santhazsolt/stm32-based-quadcopter-drone/hardware/image/3D/3D.pdf

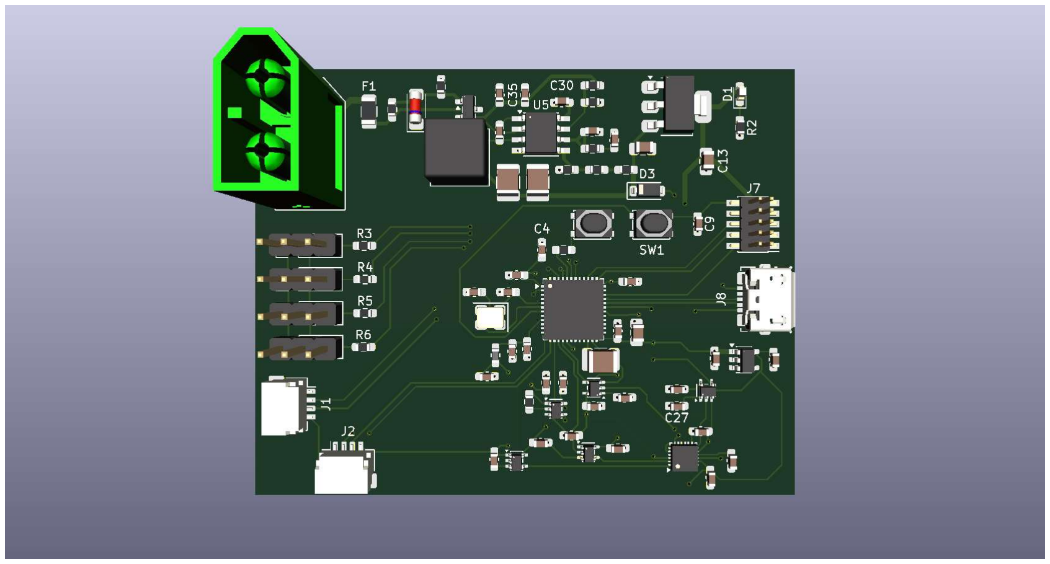
[picture p24: figure]
