santhazsolt/stm32-based-quadcopter-drone/hardware/image/pcb/flight_controllerV1_PCB.png

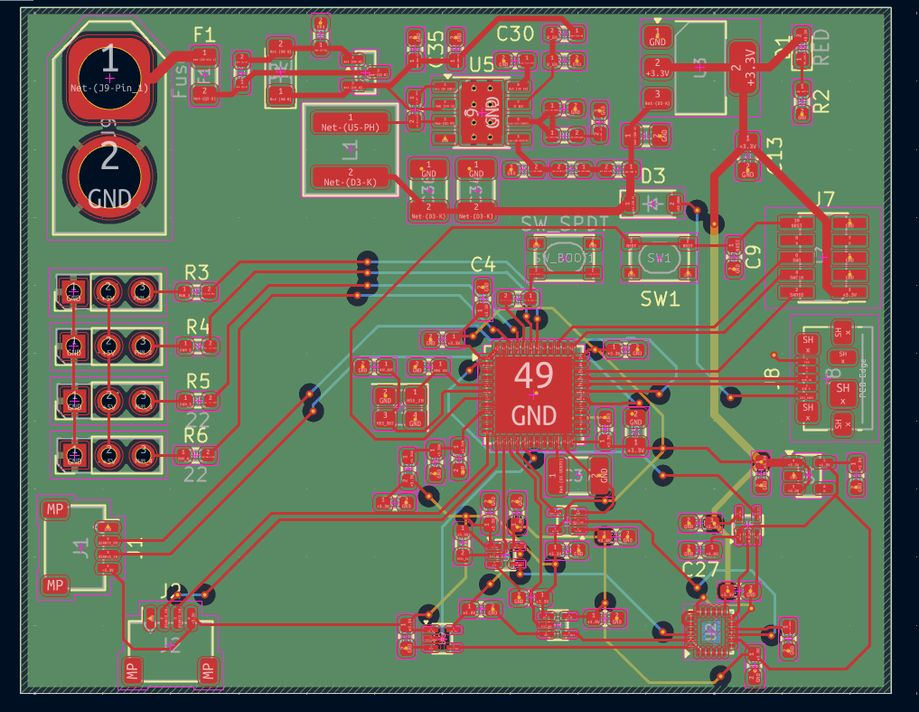
hardware/image/pcb/flight_controllerV1_PCB.png
