santhazsolt/stm32-based-quadcopter-drone/image/schematic/flight_controller_version1.pdf

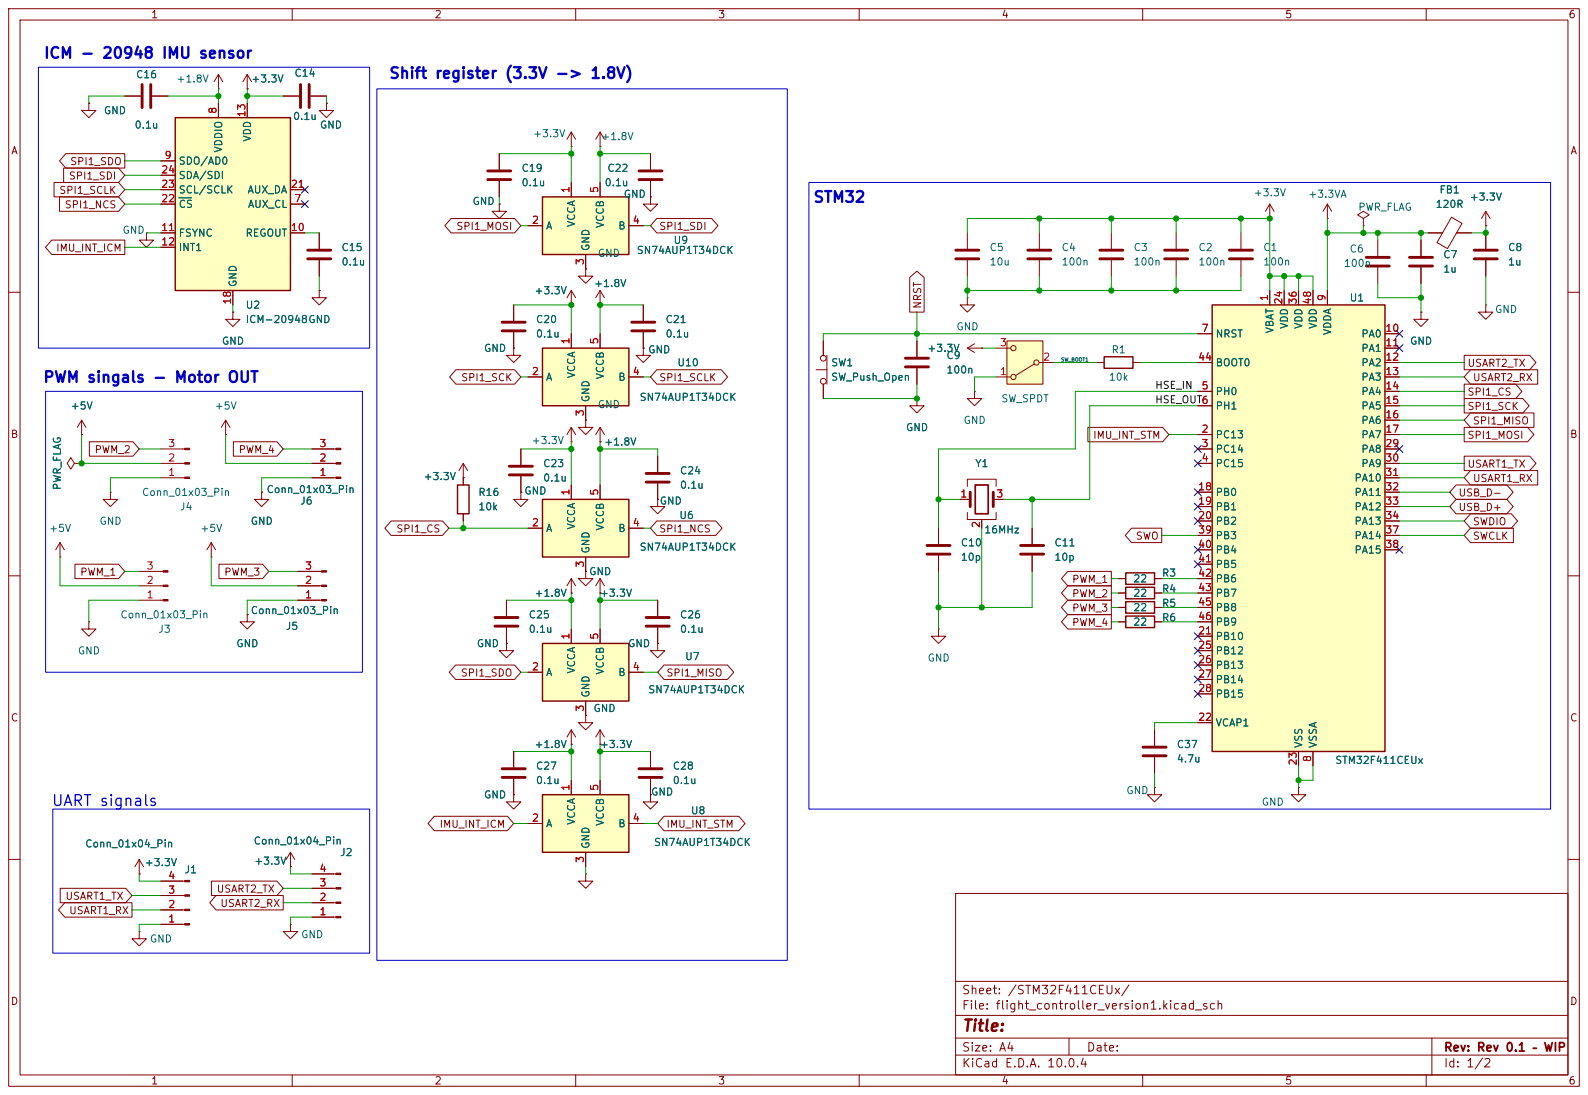
[picture p26: page 1]

Size: A4 | Rev: Rev 0.1 – WIP
KiCad E.D.A. 10.0.4 | Id: 1/2

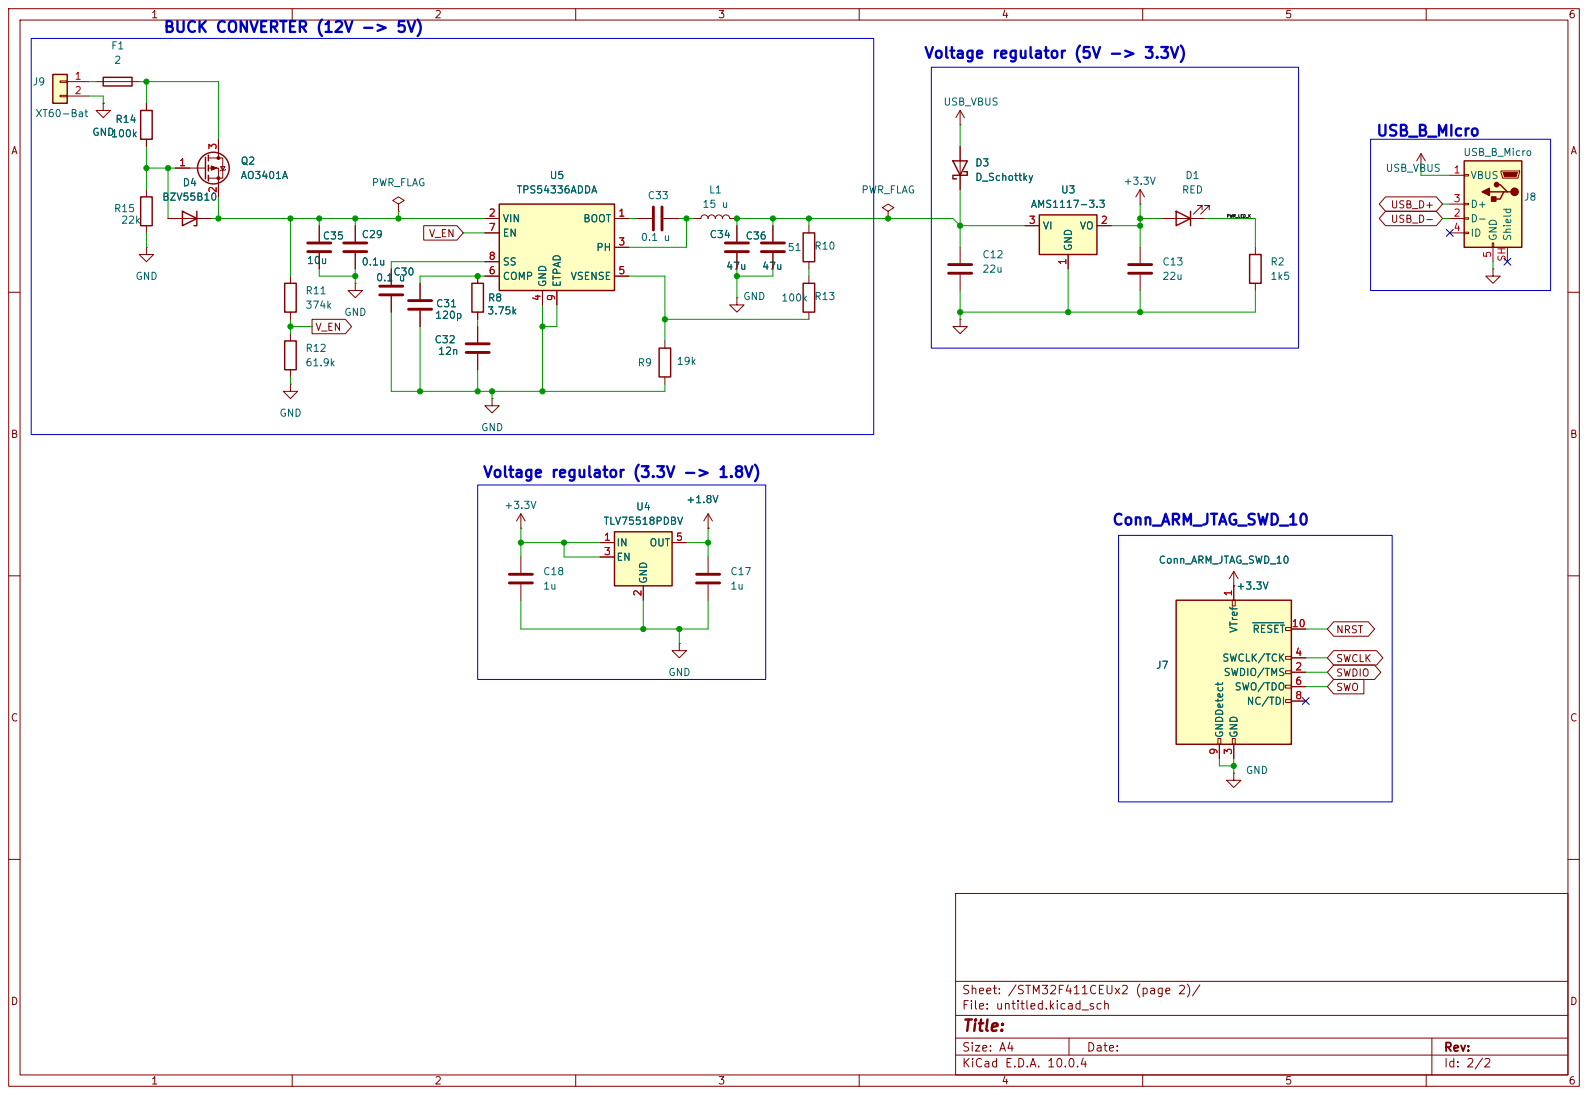
[picture p27: page 2]

Size: A4 | Rev:
KiCad E.D.A. 10.0.4 | Id: 2/2
