santhazsolt/stm32-based-quadcopter-drone/hardware/image/pcb/flight_controller_version1-B_Cu.pdf

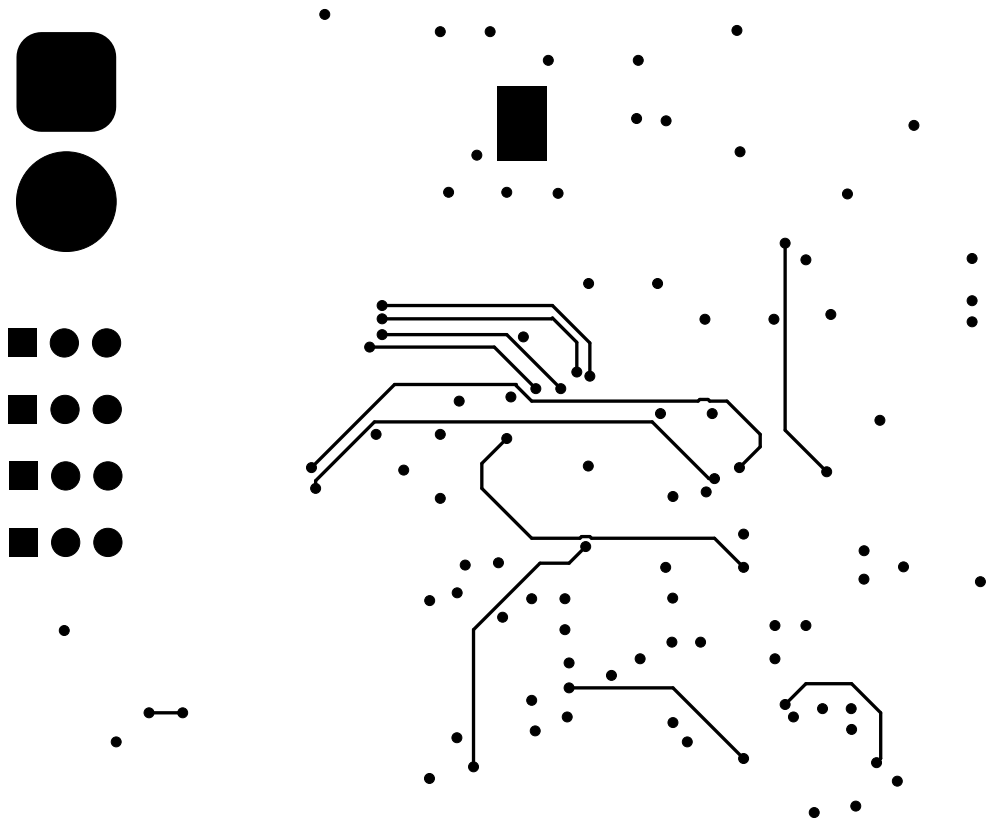
[picture p28: page 1]
