santhazsolt/stm32-based-quadcopter-drone/hardware/image/pcb/flight_controller_version1-B_Mask.pdf

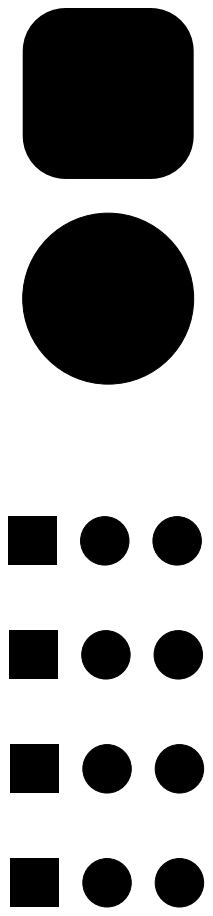
[picture p29: page 1]
