santhazsolt/stm32-based-quadcopter-drone/hardware/image/pcb/flight_controller_version1-F_Silkscreen.pdf

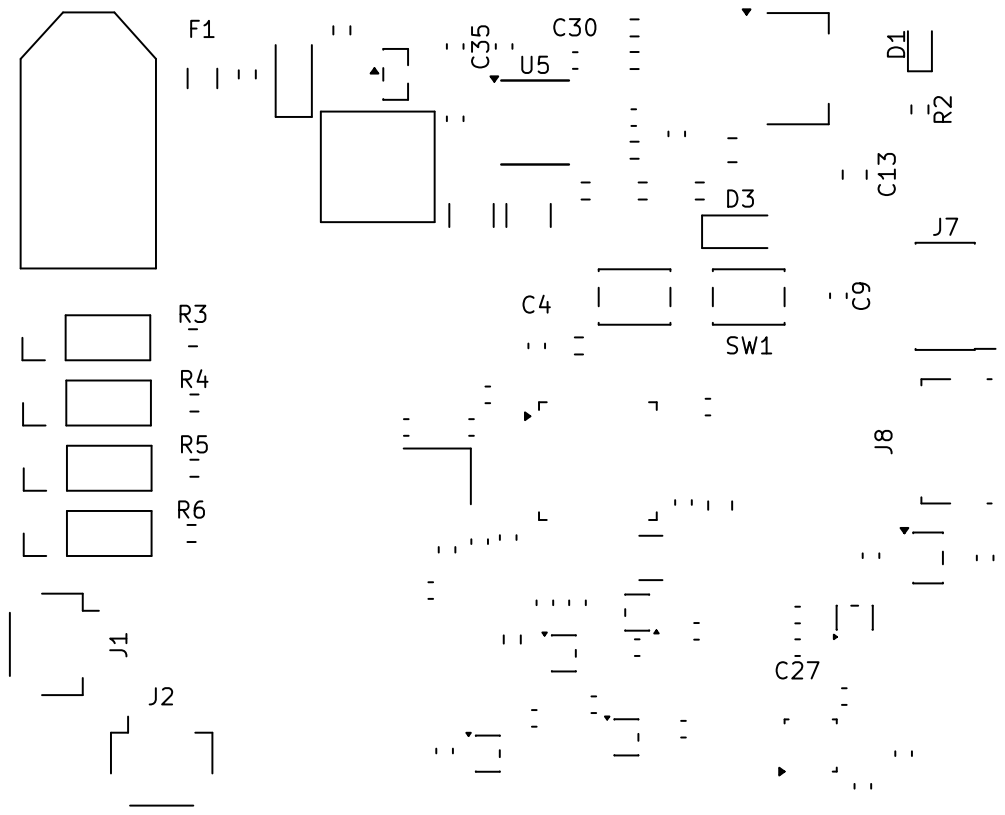
[picture p30: page 1]
