santhazsolt/stm32-based-quadcopter-drone/hardware/image/pcb/flight_controller_version1-In1_Cu.pdf

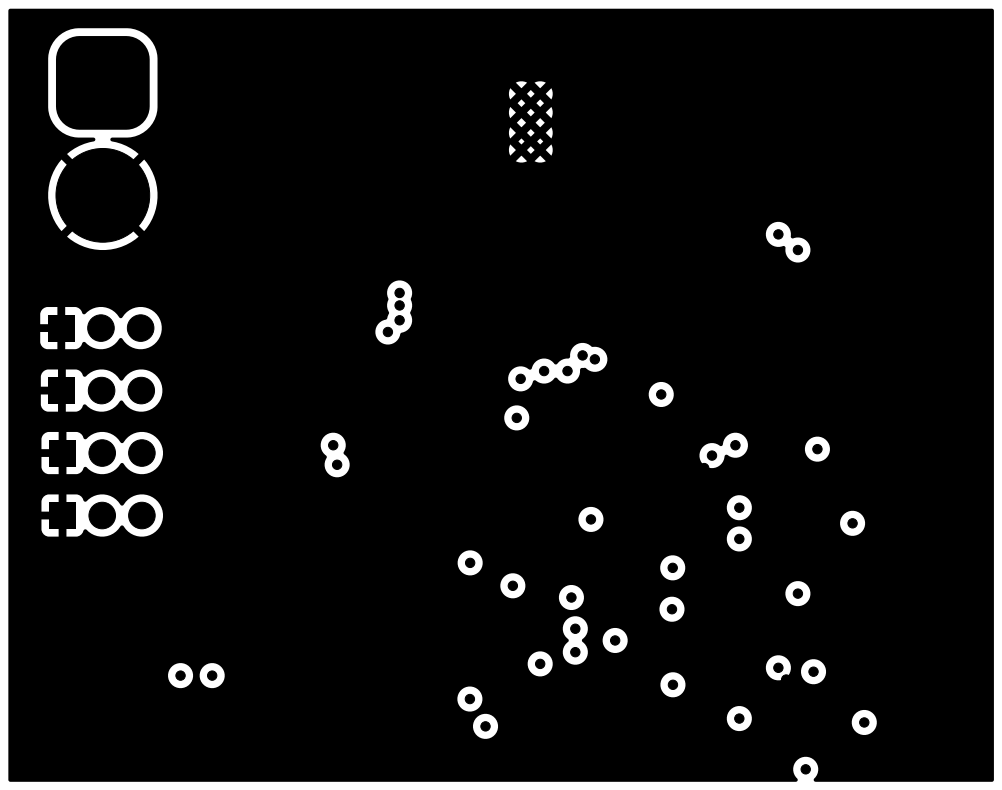
[picture p31: page 1]
