santhazsolt/stm32-based-quadcopter-drone/hardware/image/pcb/flight_controller_version1-In2_Cu.pdf

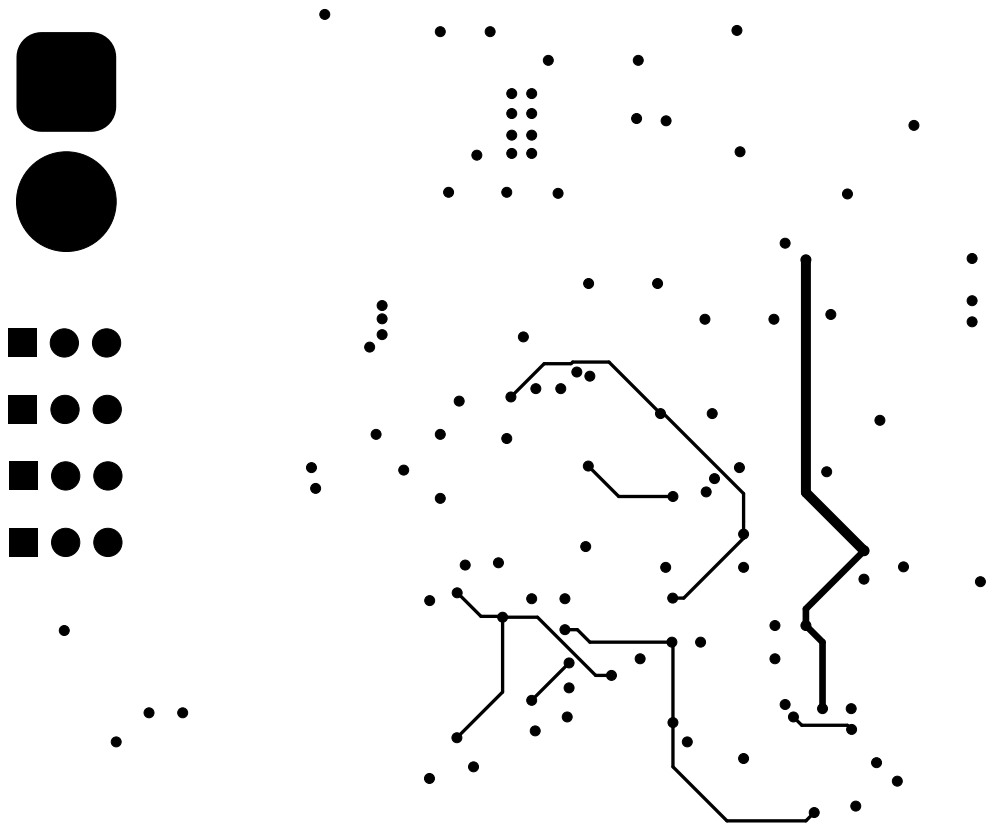
[picture p32: page 1]
