santhazsolt/stm32-based-quadcopter-drone/image/pcb/flight_controller_version1-F_Cu.pdf

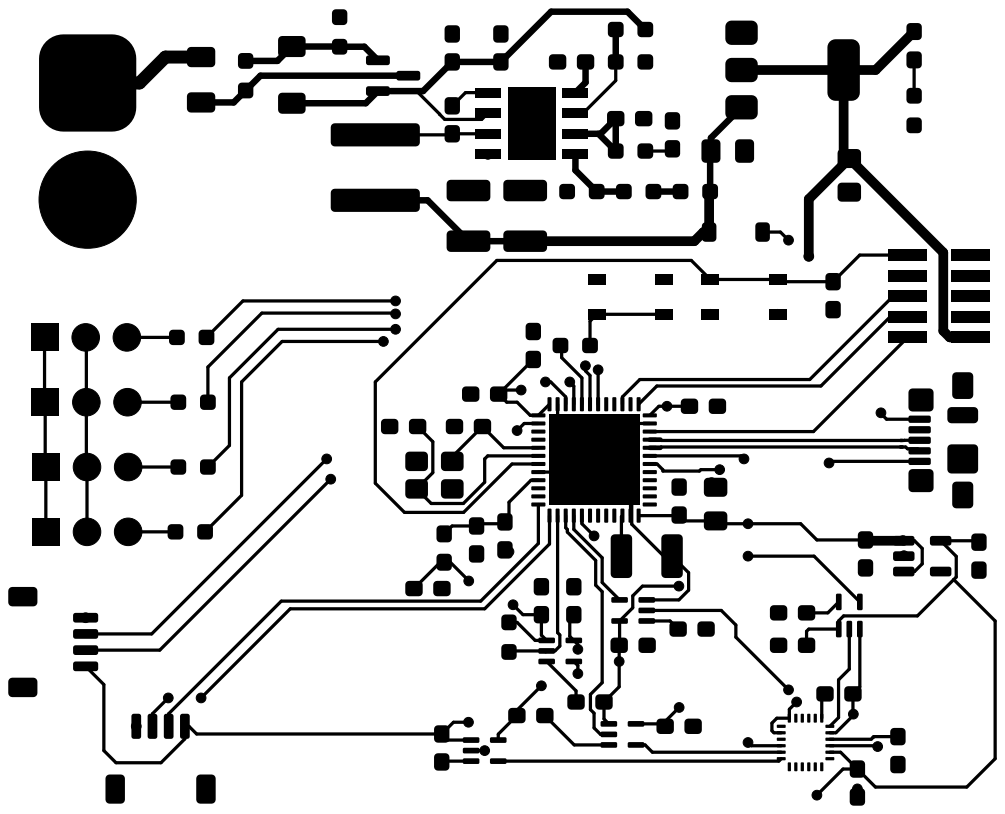
[picture p33: page 1]
