santhazsolt/stm32-based-quadcopter-drone/image/pcb/flight_controller_version1-F_Mask.pdf

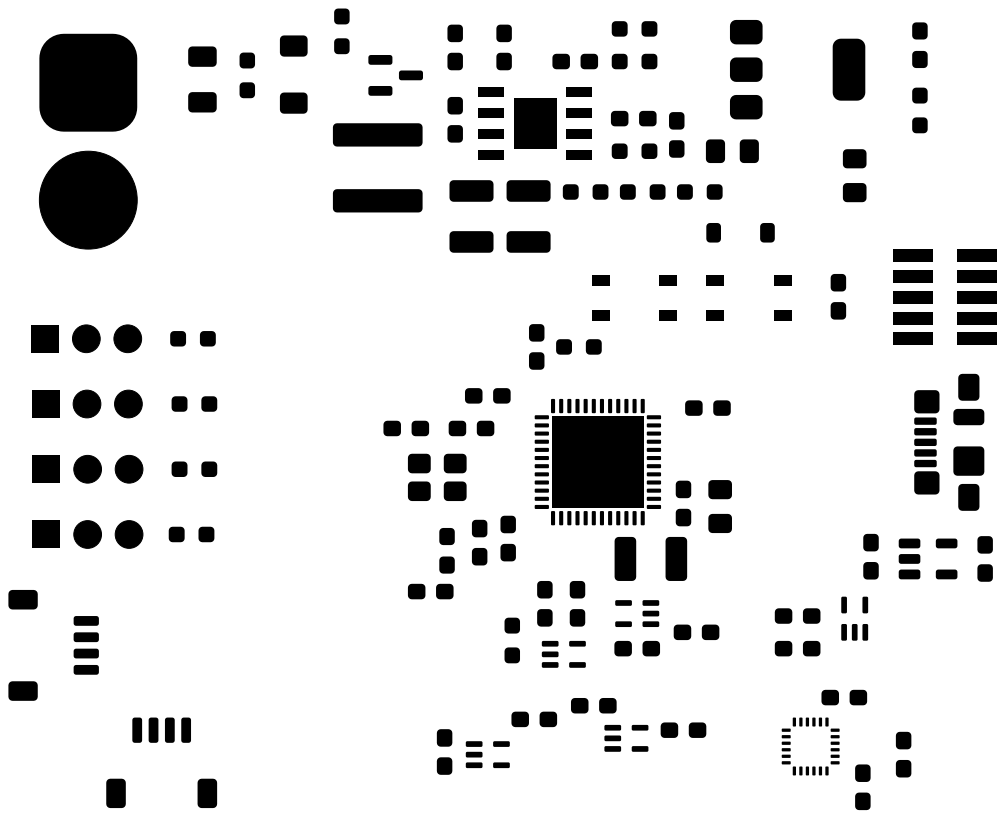
[picture p34: page 1]
