santhazsolt/stm32-based-quadcopter-drone/image/pcb/flight_controller_version1-F_Paste.pdf

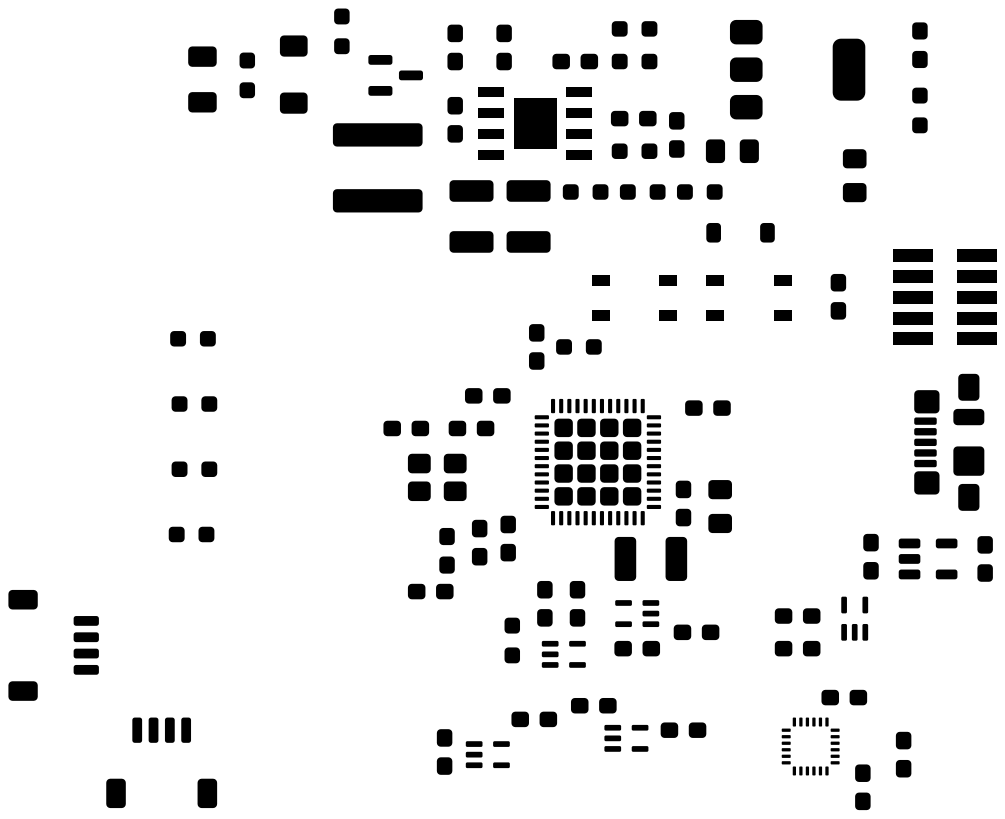
[picture p35: page 1]
