santhazsolt/stm32-based-quadcopter-drone/hardware/pcb/flight_controller_version1.kicad_pcb

## KiCad design hardware/pcb/flight_controller_version1.kicad_pcb (2026-10-06)

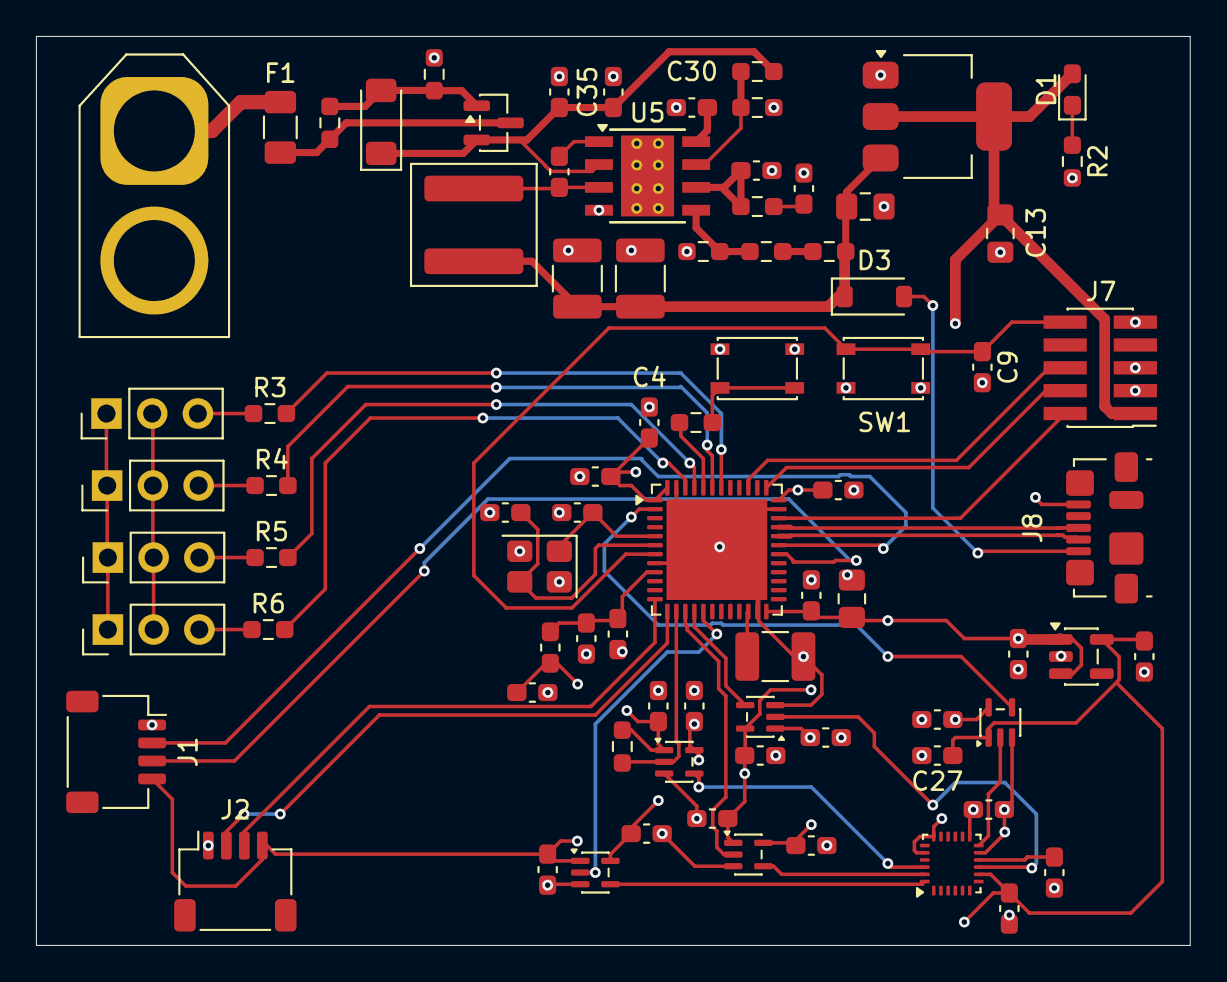
[picture p36: board flight_controller_version1.kicad_pcb from above]

Board: 4 copper layers, 64.1 x 50.5 mm, 81 parts (0 on the bottom side), 54 nets.

Parts:
C1, C2, C3, C4, C6, C9: 100n; C_0603_1608Metric_Pad1.08x0.95mm_HandSolder
C5: 10u; C_0805_2012Metric_Pad1.18x1.45mm_HandSolder
C7, C8, C17, C18: 1u; C_0603_1608Metric_Pad1.08x0.95mm_HandSolder
C10, C11: 10p; C_0603_1608Metric_Pad1.08x0.95mm_HandSolder
C12, C13: 22u; C_0805_2012Metric_Pad1.18x1.45mm_HandSolder
C14, C15, C16, C19, C20, C21, C22, C23, C24, C25, C26, C27, C28, C29: 0.1u; C_0603_1608Metric_Pad1.08x0.95mm_HandSolder
C30, C33: 0.1 u; C_0603_1608Metric_Pad1.08x0.95mm_HandSolder
C31: 120p; C_0603_1608Metric_Pad1.08x0.95mm_HandSolder
C32: 12n; C_0603_1608Metric_Pad1.08x0.95mm_HandSolder
C34, C36: 47u; C_1210_3225Metric_Pad1.33x2.70mm_HandSolder
C35: 10u; C_0603_1608Metric_Pad1.08x0.95mm_HandSolder
C37: 4.7u; C_1210_3225Metric_Pad1.33x2.70mm_HandSolder
D1: RED; LED_0603_1608Metric_Pad1.05x0.95mm_HandSolder
D3: D_Schottky; D_SOD-123
D4: BZV55B10; D_MiniMELF
F1: Fuse; Fuse_1206_3216Metric
FB1: 120R; L_0603_1608Metric_Pad1.05x0.95mm_HandSolder
J1, J2: Conn_01x04_Pin; JST_SH_SM04B-SRSS-TB_1x04-1MP_P1.00mm_Horizontal
J3, J4, J5, J6: Conn_01x03_Pin; PinHeader_1x03_P2.54mm_Vertical
J7: Conn_ARM_JTAG_SWD_10; PinHeader_2x05_P1.27mm_Vertical_SMD
J8: USB_B_Micro; USB_Micro-B_Molex_47346-0001
J9: XT60-Bat; AMASS_XT60-M_1x02_P7.20mm_Vertical
L1: 15 u; L_Coilcraft_XAL6060-XXX
Q2: AO3401A; SOT-23
R1, R16: 10k; R_0603_1608Metric_Pad0.98x0.95mm_HandSolder
R2: 1k5; R_0603_1608Metric_Pad0.98x0.95mm_HandSolder
R3, R4, R5, R6: 22; R_0603_1608Metric_Pad0.98x0.95mm_HandSolder
R8: 3.75k; R_0603_1608Metric_Pad0.98x0.95mm_HandSolder
R9: 19k; R_0603_1608Metric_Pad0.98x0.95mm_HandSolder
R10: 51; R_0603_1608Metric_Pad0.98x0.95mm_HandSolder
R11: 374k; R_0603_1608Metric_Pad0.98x0.95mm_HandSolder
R12: 61.9k; R_0603_1608Metric_Pad0.98x0.95mm_HandSolder
R13, R14: 100k; R_0603_1608Metric_Pad0.98x0.95mm_HandSolder
R15: 22k; R_0603_1608Metric_Pad0.98x0.95mm_HandSolder
SW1: SW_Push_Open; SW_SPST_PTS810
SW_BOOT1: SW_SPDT; SW_SPST_PTS810
U1: STM32F411CEUx; QFN-48-1EP_7x7mm_P0.5mm_EP5.6x5.6mm
U2: ICM-20948; InvenSense_QFN-24_3x3mm_P0.4mm
U3: AMS1117-3.3; SOT-223-3_TabPin2
U4: TLV75518PDBV; SOT-23-5
U5: TPS54336ADDA; TI_SO-PowerPAD-8_ThermalVias
U6, U7, U8, U9, U10: SN74AUP1T34DCK; SOT-353_SC-70-5
Y1: 16MHz; Crystal_SMD_3225-4Pin_3.2x2.5mm

Connections:
+1.8V: C16.1, C17.1, C21.1, C22.1, C24.1, C25.1, C27.1, U2.8 (VDDIO), U4.5 (OUT), U6.5 (VCCB), U7.1 (VCCA), U8.1 (VCCA), U9.5 (VCCB), U10.5 (VCCB)
+3.3V: C1.1, C2.1, C3.1, C4.1, C5.1, C8.1, C13.1, C14.1, C18.1, C19.1, C20.1, C23.1, C26.1, C28.1, D1.2 (A), FB1.2, J1.4, J2.4, J7.1 (VTref), R16.1, U1.1 (VBAT), U1.24 (VDD), U1.36 (VDD), U1.48 (VDD), U2.13 (VDD), U3.2 (VO), U4.1 (IN), U4.3 (EN), U6.1 (VCCA), U7.5 (VCCB), U8.5 (VCCB), U9.1 (VCCA), U10.1 (VCCA)
+3.3VA: C6.1, C7.1, FB1.1, U1.9 (VDDA)
+5V: J3.2, J4.2, J5.2, J6.2
/STM32F411CEUx2 (page 2)/PWR_LED_K: D1.1 (K), R2.1
/STM32F411CEUx/HSE_IN: C10.1, U1.5 (PH0), Y1.1
/STM32F411CEUx/HSE_OUT: C11.1, U1.6 (PH1), Y1.3
GND: C1.2, C2.2, C3.2, C4.2, C5.2, C6.2, C7.2, C8.2, C9.2, C10.2, C11.2, C12.2, C13.2, C14.2, C15.2, C16.2, C17.2, C18.2, C19.2, C20.2, C21.2, C22.2, C23.2, C24.2, C25.2, C26.2, C27.2, C28.2, C29.2, C30.2, C31.2, C32.1, C34.1, C35.2, C36.1, C37.2, J1.1, J2.1, J3.1, J4.1, J5.1, J6.1, J7.3 (GND), J7.5 (GND), J7.9 (GNDDetect), J8.5 (GND), J9.2, R2.2, R9.1, R12.2, R15.2, SW1.1 (A), SW_BOOT1.1 (A), U1.8 (VSSA), U1.23 (VSS), U1.35 (VSS), U1.47 (VSS), U1.49 (VSS), U2.11 (FSYNC), U2.18 (GND), U2.20 (GND), U3.1 (GND), U4.2 (GND), U5.4 (GND), U5.9 (ETPAD), U6.3 (GND), U7.3 (GND), U8.3 (GND), U9.3 (GND), U10.3 (GND), Y1.2 (G), Y1.4 (G)
IMU_INT_ICM: U2.12 (INT1), U8.2 (A)
IMU_INT_STM: U1.2 (PC13), U8.4 (B)
NRST: C9.1, J7.10 (~RESET), SW1.2 (B), U1.7 (NRST)
unnamed: C32.2, R8.2
unnamed: C12.1, C34.2, C36.2, D3.1 (K), L1.2, R10.1, U3.3 (VI)
unnamed: D4.2 (A), Q2.1 (G), R14.2, R15.1
unnamed: C29.1, C35.1, D4.1 (K), Q2.2 (S), R11.1, U5.2 (VIN)
unnamed: F1.1, J9.1
unnamed: F1.2, Q2.3 (D), R14.1
unnamed: R10.2, R13.1
unnamed: R1.1, SW_BOOT1.2 (B)
unnamed: R1.2, U1.44 (BOOT0)
unnamed: R3.2, U1.42 (PB6)
unnamed: R4.2, U1.43 (PB7)
unnamed: R5.2, U1.45 (PB8)
unnamed: R6.2, U1.46 (PB9)
unnamed: C37.1, U1.22 (VCAP1)
unnamed: C15.1, U2.10 (REGOUT)
unnamed: C33.1, U5.1 (BOOT)
unnamed: C31.1, R8.1, U5.6 (COMP)
unnamed: C33.2, L1.1, U5.3 (PH)
unnamed: C30.1, U5.8 (SS)
unnamed: R9.2, R13.2, U5.5 (VSENSE)
PWM_1: J3.3, R3.1
PWM_2: J4.3, R4.1
PWM_3: J5.3, R5.1
PWM_4: J6.3, R6.1
SPI1_CS: R16.2, U1.14 (PA4), U6.2 (A)
SPI1_MISO: U1.16 (PA6), U7.4 (B)
SPI1_MOSI: U1.17 (PA7), U9.2 (A)
SPI1_NCS: U2.22 (~CS), U6.4 (B)
SPI1_SCK: U1.15 (PA5), U10.2 (A)
SPI1_SCLK: U2.23 (SCL/SCLK), U10.4 (B)
SPI1_SDI: U2.24 (SDA/SDI), U9.4 (B)
SPI1_SDO: U2.9 (SDO/AD0), U7.2 (A)
SWCLK: J7.4 (SWCLK/TCK), U1.37 (PA14)
SWDIO: J7.2 (SWDIO/TMS), U1.34 (PA13)
SWO: J7.6 (SWO/TDO), U1.39 (PB3)
USART1_RX: J1.2, U1.31 (PA10)
USART1_TX: J1.3, U1.30 (PA9)
USART2_RX: J2.2, U1.13 (PA3)
USART2_TX: J2.3, U1.12 (PA2)
USB_D+: J8.3 (D+), U1.33 (PA12)
USB_D-: J8.2 (D-), U1.32 (PA11)
USB_VBUS: D3.2 (A), J8.1 (VBUS)
V_EN: R11.2, R12.1, U5.7 (EN)
