santhazsolt/stm32-based-quadcopter-drone/firmware/Src/main.c

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
/* Includes ------------------------------------------------------------------*/
#include "main.h"

/* USER CODE BEGIN Includes */
#include "stdio.h"
#include "icm_20948_2.h"
#include "arm_math.h"
#include "imu_data.h"
#include "euler_angles.h"
#include "pid_control.h"
#include "string.h"
#include "drone_control.h"


/* USER CODE END Includes */

SPI_HandleTypeDef hspi1;

TIM_HandleTypeDef htim1;
TIM_HandleTypeDef htim4;

UART_HandleTypeDef huart2;

/* USER CODE BEGIN PV */
int dumb_data = 0;
volatile uint8_t timer_flag = 0;
volatile uint32_t overrun = 0;

#define IBUS_FRAME_LEN 32
#define IBUS_CHANNELS  14

typedef struct {
    uint16_t ch[IBUS_CHANNELS];   // 14 channels
} ibus_data_t;


int sum_gyro_x, sum_gyro_y, sum_gyro_z;
int16_t mag_x, mag_y, mag_z;
imu_norm imu_norm_var;
euler_angles euler_temp;
uint8_t address, data;
int16_t counter_time;

volatile ibus_data_t ibus_channels = {0};
volatile uint8_t ibus_buffer[IBUS_FRAME_LEN];
volatile uint8_t ibus_index = 0;

extern DroneTypeDef drone;
/* USER CODE END PV */

void SystemClock_Config(void);
static void MX_GPIO_Init(void);
static void MX_SPI1_Init(void);
static void MX_TIM4_Init(void);
static void MX_USART2_UART_Init(void);
static void MX_TIM1_Init(void);
/**
  * @brief  The application entry point.
  * @retval int
  */
int main(void)
{
  /* USER CODE BEGIN 1 */

//	uint8_t address, data;
//	int16_t counter_time;
	icm_20948_data icm_data;

  /* USER CODE END 1 */

  /* MCU Configuration--------------------------------------------------------*/

  /* Reset of all peripherals, Initializes the Flash interface and the Systick. */
  HAL_Init();

  /* Configure the system clock */
  SystemClock_Config();

  /* Initialize all configured peripherals */
  MX_GPIO_Init();
  MX_SPI1_Init();
  MX_TIM4_Init();
  MX_USART2_UART_Init();
  MX_TIM1_Init();
  /* USER CODE BEGIN 2 */
  HAL_Delay(100);
  icm_20948_init();
  icm_20948_selftest_dump();

  HAL_TIM_PWM_Start(&htim1, TIM_CHANNEL_1);
  HAL_TIM_PWM_Start(&htim1, TIM_CHANNEL_2);
  HAL_TIM_PWM_Start(&htim1, TIM_CHANNEL_3);
  HAL_TIM_PWM_Start(&htim1, TIM_CHANNEL_4);

  set_motor_voltage(&drone.motor_drone, MOTOR_1, 0);
  set_motor_voltage(&drone.motor_drone, MOTOR_2, 0);
  set_motor_voltage(&drone.motor_drone, MOTOR_3, 0);
  set_motor_voltage(&drone.motor_drone, MOTOR_4, 0);

  overrun = 0;

  /* USER CODE END 2 */

  /* Infinite loop */
  /* USER CODE BEGIN WHILE */
  while (1)
  {
    /* USER CODE END WHILE */

    /* USER CODE BEGIN 3 */
  }
  /* USER CODE END 3 */
}

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
/* USER CODE BEGIN 4 */
//int __io_putchar(int ch)
//{
//  // Ship byte over serial to your FTDI adapter with a safety timeout
//  HAL_UART_Transmit(&huart1, (uint8_t *)&ch, 1, 10);
//  return ch;
//}

// Validate the frame checksum (matches your Arduino frameIsValid)
uint8_t ibus_frame_is_valid(void)
{
    uint16_t checksum = 0xFFFF;
    for (uint8_t i = 0; i < 30; i++)
        checksum -= ibus_buffer[i];

    uint16_t received = ibus_buffer[30] | (ibus_buffer[31] << 8);
    return (checksum == received);
}

// Decode all 14 channels (matches your Arduino decodeChannels)
void decode_ibus_channels(void)
{
    for (uint8_t ch = 0; ch < IBUS_CHANNELS; ch++)
    {
        ibus_channels.ch[ch] = ibus_buffer[2 + ch * 2] |
                               (ibus_buffer[3 + ch * 2] << 8);
    }
}

void HAL_UART_RxCpltCallback(UART_HandleTypeDef *huart)
{
    if (huart == &huart2)
    {
        uint8_t b = ibus_buffer[ibus_index];   // the byte just received

        // Same header logic as your Arduino readIbus()
        if (ibus_index == 0 && b != 0x20)
        {
            // not a start byte — keep waiting at index 0
            HAL_UART_Receive_IT(&huart2, (uint8_t *)&ibus_buffer[0], 1);
            return;
        }
        if (ibus_index == 1 && b != 0x40)
        {
            // bad second byte — reset to look for start again
            ibus_index = 0;
            HAL_UART_Receive_IT(&huart2, (uint8_t *)&ibus_buffer[0], 1);
            return;
        }

        ibus_index++;

        if (ibus_index == IBUS_FRAME_LEN)
        {
            ibus_index = 0;
            if (ibus_frame_is_valid())
                decode_ibus_channels();
        }

        // queue reception of the next byte into the next buffer slot
        HAL_UART_Receive_IT(&huart2, (uint8_t *)&ibus_buffer[ibus_index], 1);
    }
}

void HAL_TIM_PeriodElapsedCallback(TIM_HandleTypeDef *htim)
{
	if (htim == &htim4)  // make sure it's the right timer
	    {
	        if (timer_flag == 1)
	            overrun++;
	        timer_flag = 1;
	    }
	//	timer_flag = 1;
//	if(htim == &htim1)
//	{
//		 icm_20948_read_data(&icm_data);
//		 sensor2imu(icm_data, &imu_norm_var);
//		 complementary_filter_euler(imu_norm_var, &euler_temp);
//         drone_update_angle(&drone, euler_temp);
//         if(!drone.start_flight)
//         {
//        	 drone_set_zero(&drone);
//         }
//         else
//         {
//             drone_apply_control(&drone, reference);
//
//         }
//	}

}
/* USER CODE END 4 */
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
