santhazsolt/stm32-based-quadcopter-drone/firmware/Quadcopter_Blackpill_IMU_PID2.ioc

Mcu.UserName=STM32F411CEUx
PA9.GPIO_Label=M2_PWM
PA11.GPIO_Label=M4_PWM
PA6.GPIO_Label=SPI_MISO
PA13.Signal=SYS_JTMS-SWDIO
PA8.GPIO_Label=M1_PWM
PA9.Signal=S_TIM1_CH2
PA5.Signal=SPI1_SCK
PA10.GPIO_Label=M3_PWM
PA8.Signal=S_TIM1_CH1
PA2.Signal=USART2_TX
PA4.Signal=GPIO_Output
PA6.Signal=SPI1_MISO
PA7.GPIO_Label=SPI_MOSI
PA11.Signal=S_TIM1_CH4
PA10.Signal=S_TIM1_CH3
PA14.Signal=SYS_JTCK-SWCLK
PA4.GPIO_Label=SPI_CS
PA3.Signal=USART2_RX
PA7.Signal=SPI1_MOSI
