santhazsolt/stm32-based-quadcopter-drone/firmware/Inc/main.h

#define SPI_CS_Pin GPIO_PIN_4
#define SPI_CS_GPIO_Port GPIOA
#define SPI_MISO_Pin GPIO_PIN_6
#define SPI_MISO_GPIO_Port GPIOA
#define SPI_MOSI_Pin GPIO_PIN_7
#define SPI_MOSI_GPIO_Port GPIOA
#define M1_PWM_Pin GPIO_PIN_8
#define M1_PWM_GPIO_Port GPIOA
#define M2_PWM_Pin GPIO_PIN_9
#define M2_PWM_GPIO_Port GPIOA
#define M3_PWM_Pin GPIO_PIN_10
#define M3_PWM_GPIO_Port GPIOA
#define M4_PWM_Pin GPIO_PIN_11
#define M4_PWM_GPIO_Port GPIOA
